MerylB2/Boite_stork_3D/3mf_bambu_tricolore/loquets_x14.3mf

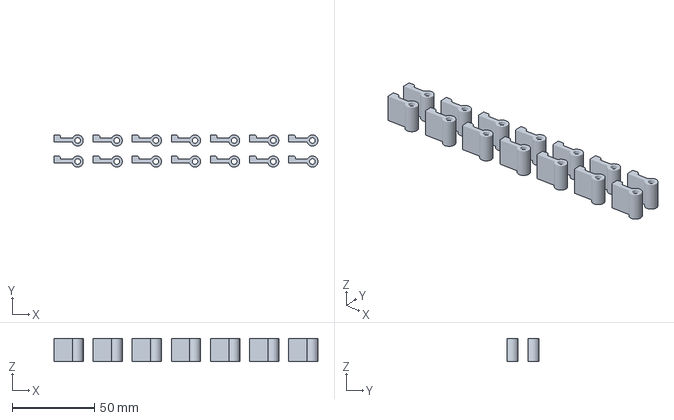
[picture p4: CAD file, 2026-10-30]
3mf_bambu_tricolore/loquets_x14.3mf
160.6 x 19.6 x 14.0 mm
