MerylB2/Boite_stork_3D/stl/7_kit_base_lwpla_couvercle.stl

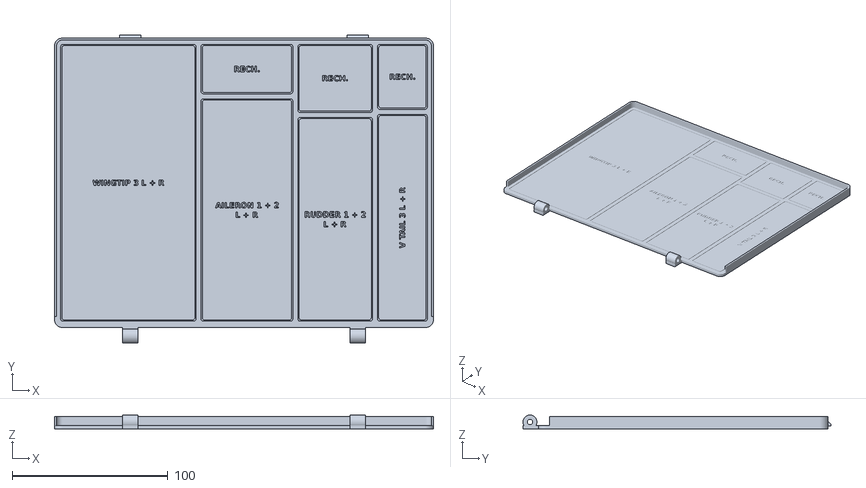
[picture p5: CAD file, 2026-10-30]
stl/7_kit_base_lwpla_couvercle.stl
243.6 x 198.0 x 9.00
