MerylB2/Boite_stork_3D/3mf_bambu_tricolore/7_kit_base_lwpla_boite.3mf

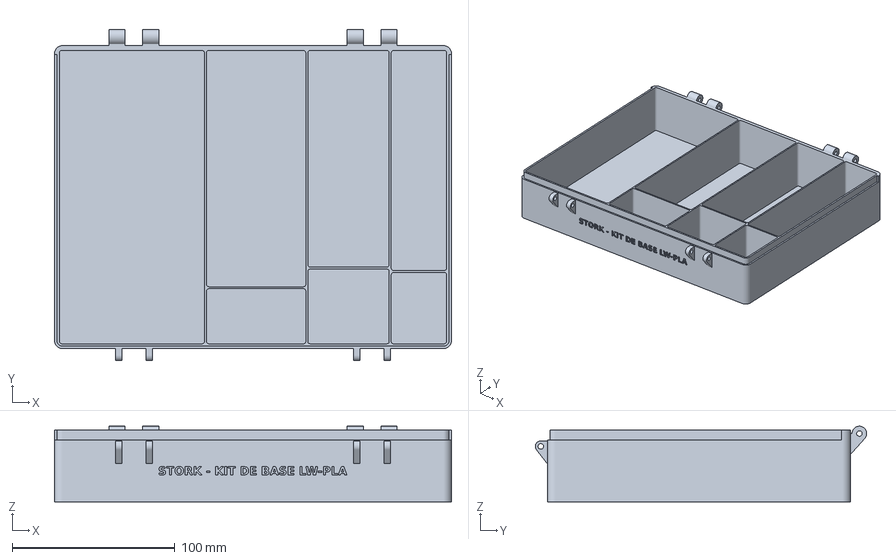
[picture p6: CAD file, 2026-10-30]
3mf_bambu_tricolore/7_kit_base_lwpla_boite.3mf
243.6 x 203.4 x 46.4 mm
