MerylB2/Boite_stork_3D/stl/2_moteurs_servos_couvercle.stl

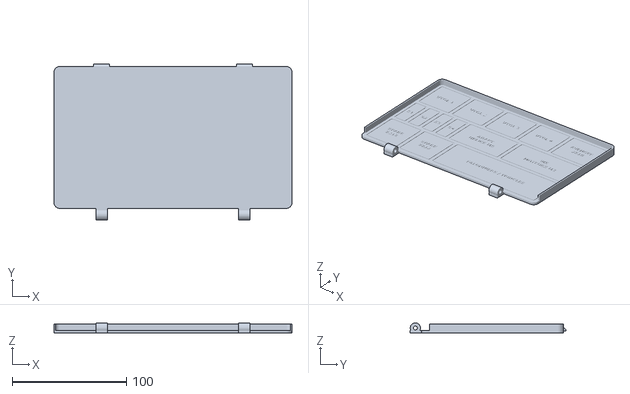
[picture p7: CAD file, 2026-10-30]
stl/2_moteurs_servos_couvercle.stl
208.0 x 136.0 x 9.00
