MerylB2/Boite_stork_3D/3mf_bambu_tricolore/2_moteurs_servos_boite.3mf

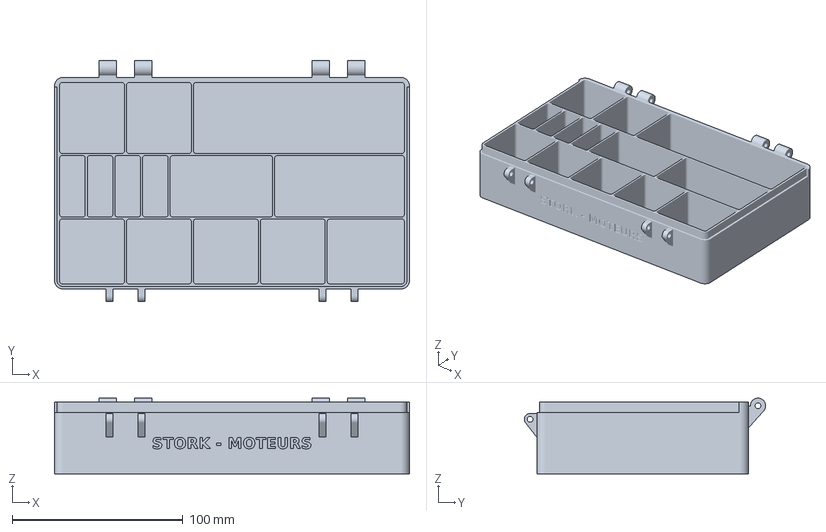
[picture p8: CAD file, 2026-10-30]
3mf_bambu_tricolore/2_moteurs_servos_boite.3mf
208.0 x 141.4 x 44.4 mm
