MerylB2/Boite_stork_3D/stl/4_quincaillerie_couvercle.stl

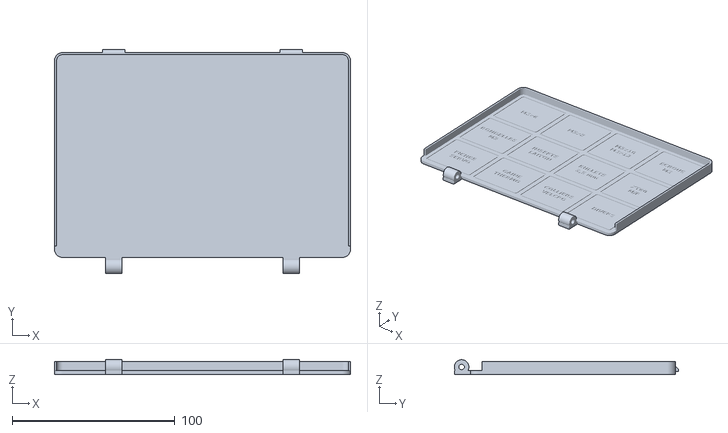
[picture p9: CAD file, 2026-10-30]
stl/4_quincaillerie_couvercle.stl
182.0 x 138.0 x 9.00
