MerylB2/Boite_stork_3D/3mf_bambu_tricolore/5_helices_boite.3mf

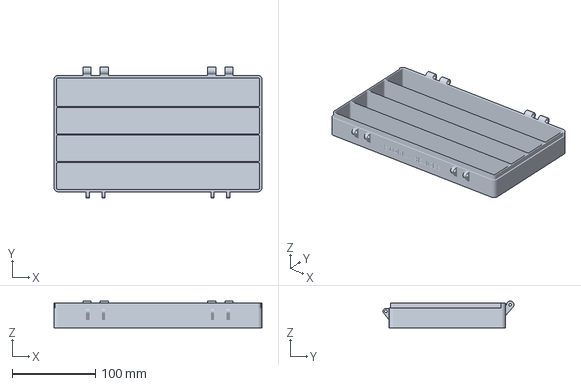
[picture p10: CAD file, 2026-10-30]
3mf_bambu_tricolore/5_helices_boite.3mf
250.0 x 157.4 x 32.4 mm
