MerylB2/Boite_stork_3D/stl/6_kit_base_petg_couvercle.stl

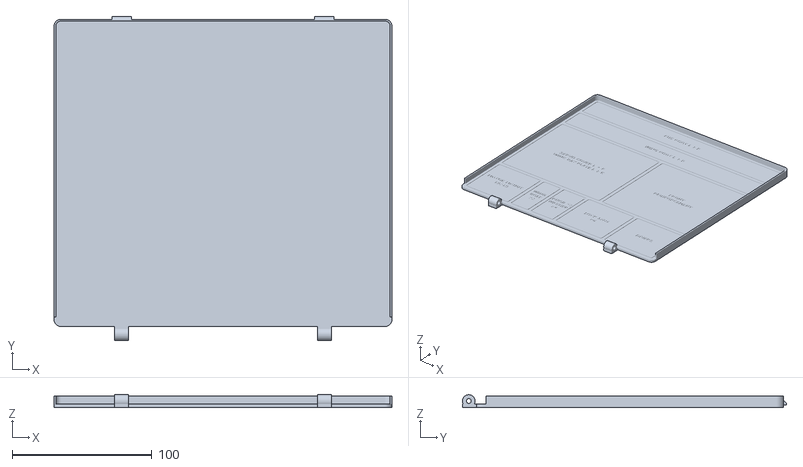
[picture p11: CAD file, 2026-10-30]
stl/6_kit_base_petg_couvercle.stl
242.0 x 232.0 x 9.00
