MerylB2/Boite_stork_3D/3mf_bambu_tricolore/2_moteurs_servos_couvercle.3mf

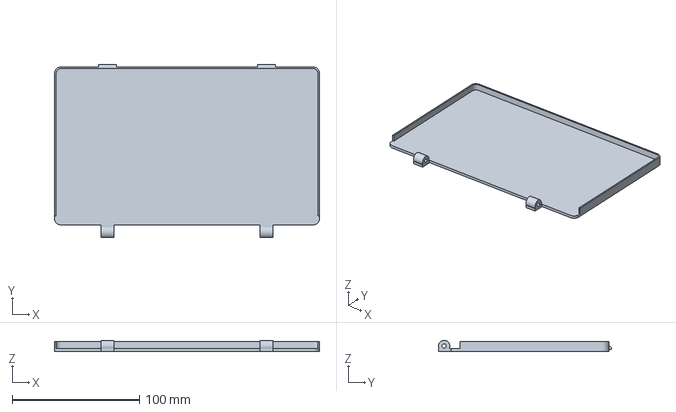
[picture p12: CAD file, 2026-10-30]
3mf_bambu_tricolore/2_moteurs_servos_couvercle.3mf
208.0 x 136.0 x 9.00 mm
