MerylB2/Boite_stork_3D/3mf_bambu_tricolore/6_kit_base_petg_boite.3mf

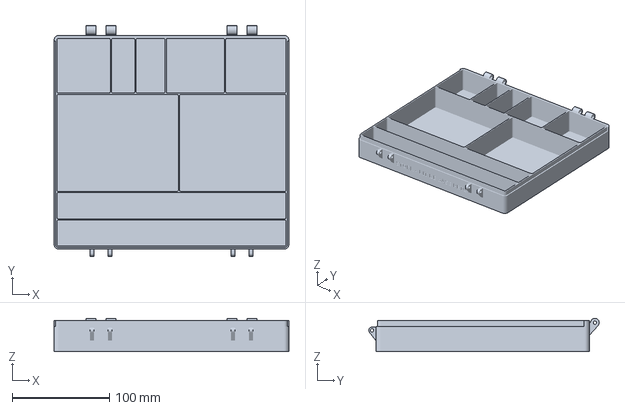
[picture p13: CAD file, 2026-10-30]
3mf_bambu_tricolore/6_kit_base_petg_boite.3mf
242.0 x 237.4 x 34.4 mm
