MerylB2/Boite_stork_3D/3mf_bambu_tricolore/4_quincaillerie_boite.3mf

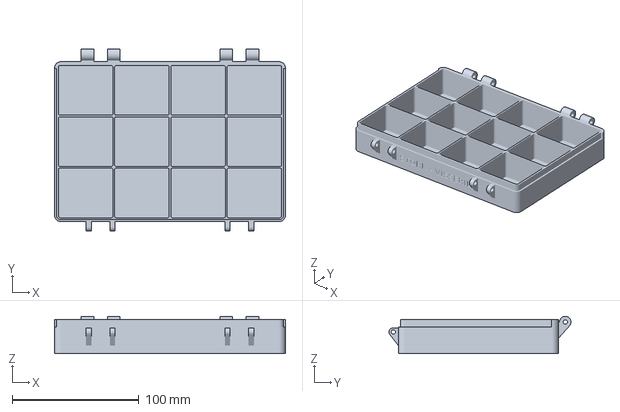
[picture p14: CAD file, 2026-10-30]
3mf_bambu_tricolore/4_quincaillerie_boite.3mf
182.0 x 143.4 x 29.4 mm
