MerylB2/Boite_stork_3D/stl/loquets_x2.stl

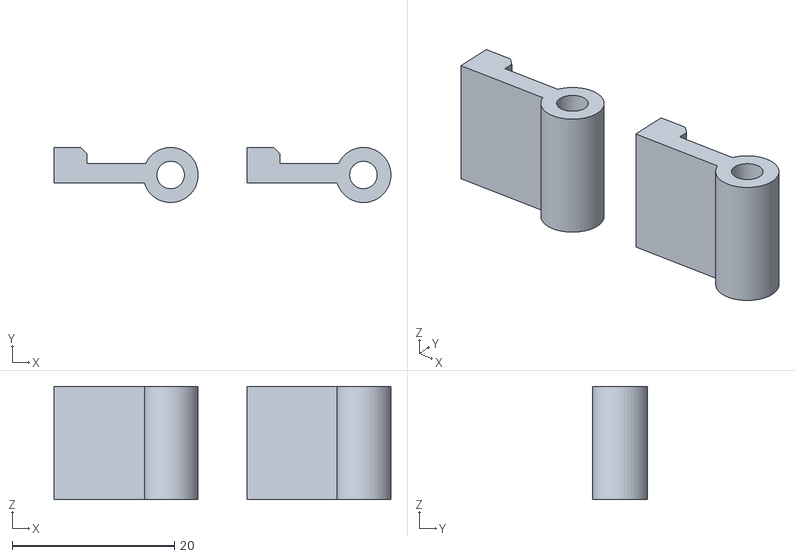
[picture p15: CAD file, 2026-10-30]
stl/loquets_x2.stl
41.6 x 6.80 x 14.0
