MerylB2/Boite_stork_3D/3mf_bambu_tricolore/3_pack_vtol_petg_couvercle.3mf

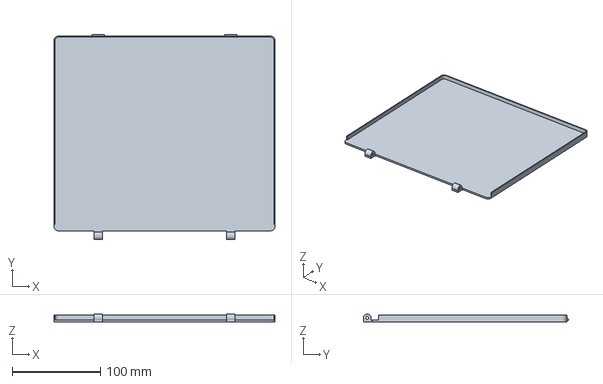
[picture p16: CAD file, 2026-10-30]
3mf_bambu_tricolore/3_pack_vtol_petg_couvercle.3mf
250.0 x 232.4 x 9.00 mm
