MerylB2/Boite_stork_3D/3mf_bambu_tricolore/5_helices_couvercle.3mf

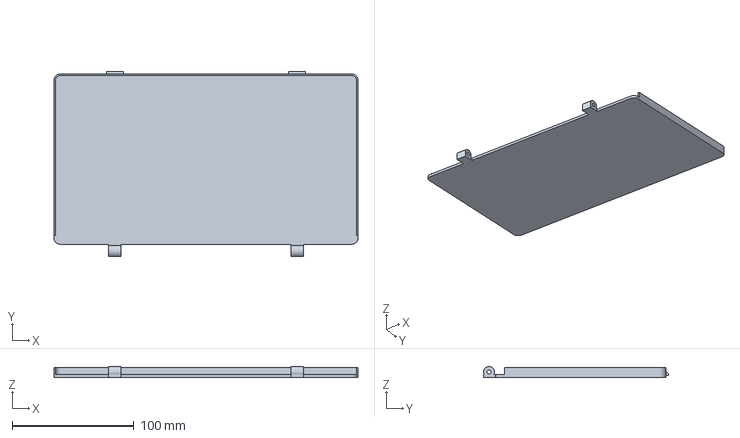
[picture p17: CAD file, 2026-10-30]
3mf_bambu_tricolore/5_helices_couvercle.3mf
250.0 x 152.0 x 9.00 mm
