MerylB2/Boite_stork_3D/stl/5_helices_couvercle.stl

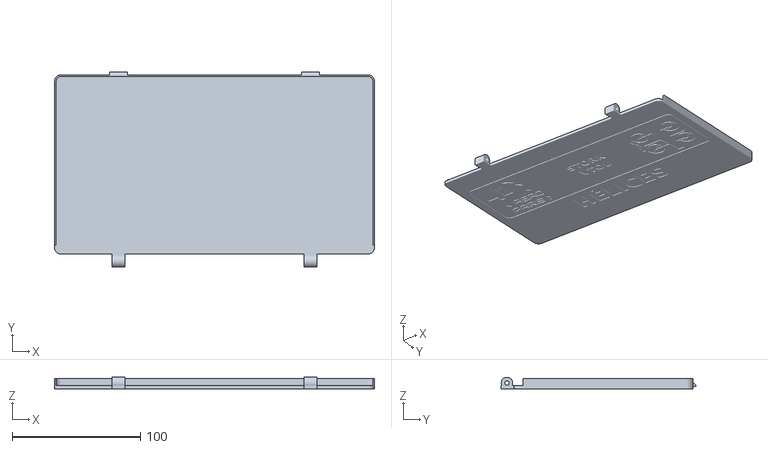
[picture p18: CAD file, 2026-10-30]
stl/5_helices_couvercle.stl
250.0 x 152.0 x 9.00
