MerylB2/Boite_stork_3D/3mf_bambu_tricolore/6_kit_base_petg_couvercle.3mf

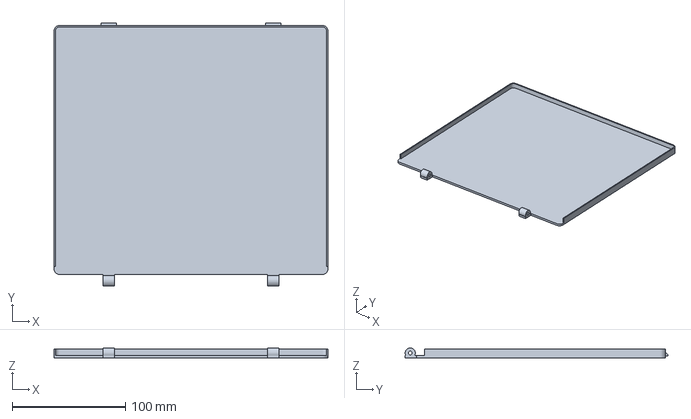
[picture p19: CAD file, 2026-10-30]
3mf_bambu_tricolore/6_kit_base_petg_couvercle.3mf
242.0 x 232.0 x 9.00 mm
