MerylB2/Boite_stork_3D/stl/3_pack_vtol_petg_boite.stl

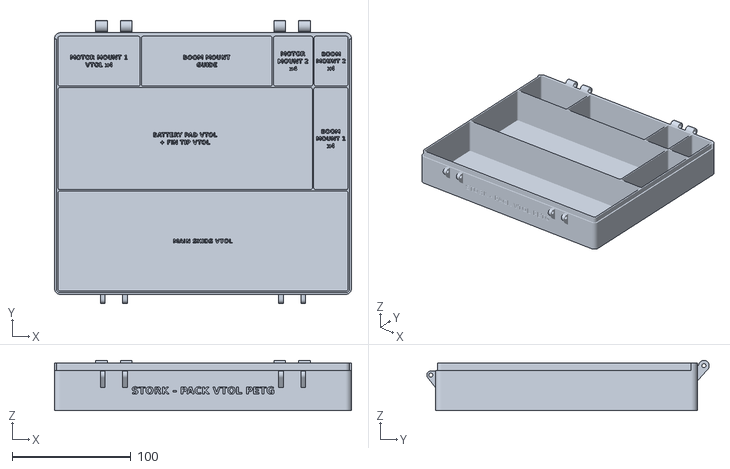
[picture p20: CAD file, 2026-10-30]
stl/3_pack_vtol_petg_boite.stl
250.0 x 237.8 x 42.4
