MerylB2/Boite_stork_3D/3mf_bambu_tricolore/1_electronique_couvercle.3mf

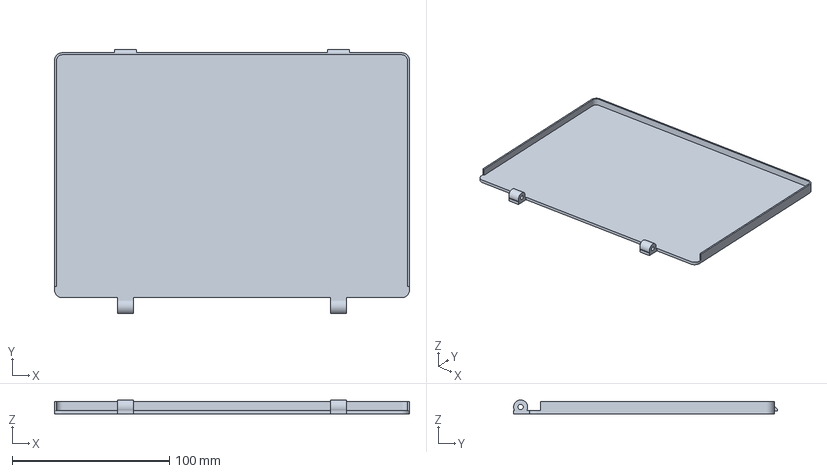
[picture p21: CAD file, 2026-10-30]
3mf_bambu_tricolore/1_electronique_couvercle.3mf
226.0 x 168.0 x 9.00 mm
