MerylB2/Boite_stork_3D/3mf_bambu_tricolore/7_kit_base_lwpla_couvercle.3mf

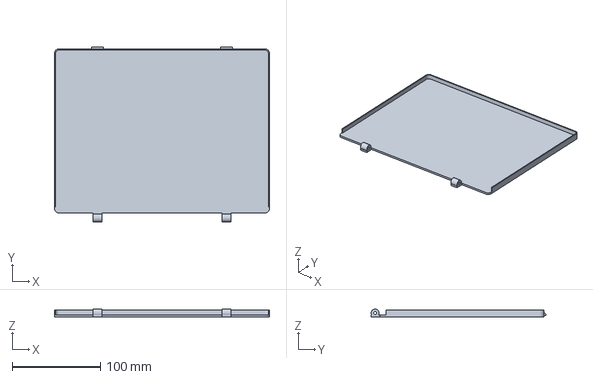
[picture p22: CAD file, 2026-10-30]
3mf_bambu_tricolore/7_kit_base_lwpla_couvercle.3mf
243.6 x 198.0 x 9.00 mm
