MerylB2/Boite_stork_3D/stl/1_electronique_boite.stl

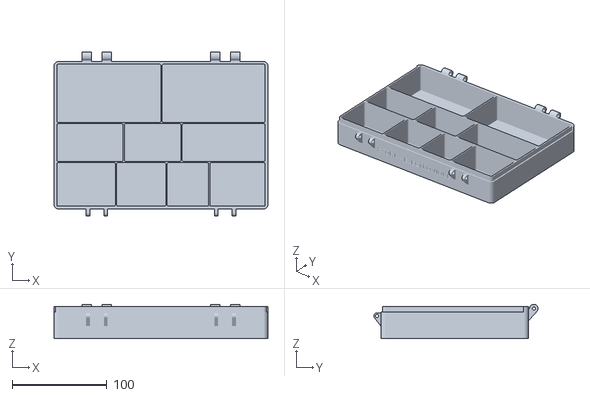
[picture p23: CAD file, 2026-10-30]
stl/1_electronique_boite.stl
226.0 x 173.4 x 36.4
