MerylB2/Boite_stork_3D/3mf_bambu_tricolore/4_quincaillerie_couvercle.3mf

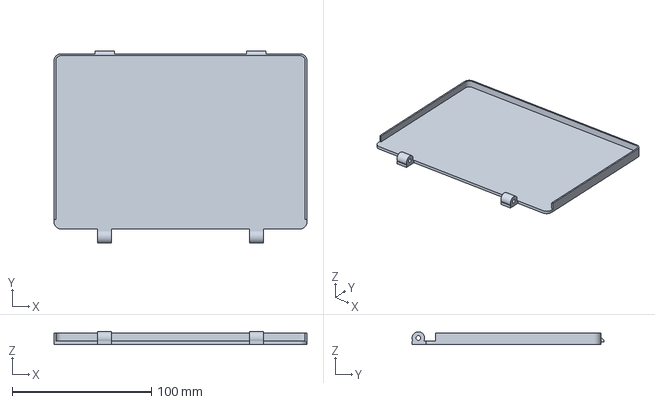
[picture p24: CAD file, 2026-10-30]
3mf_bambu_tricolore/4_quincaillerie_couvercle.3mf
182.0 x 138.0 x 9.00 mm
