MerylB2/Boite_stork_3D/stl/1_electronique_couvercle.stl

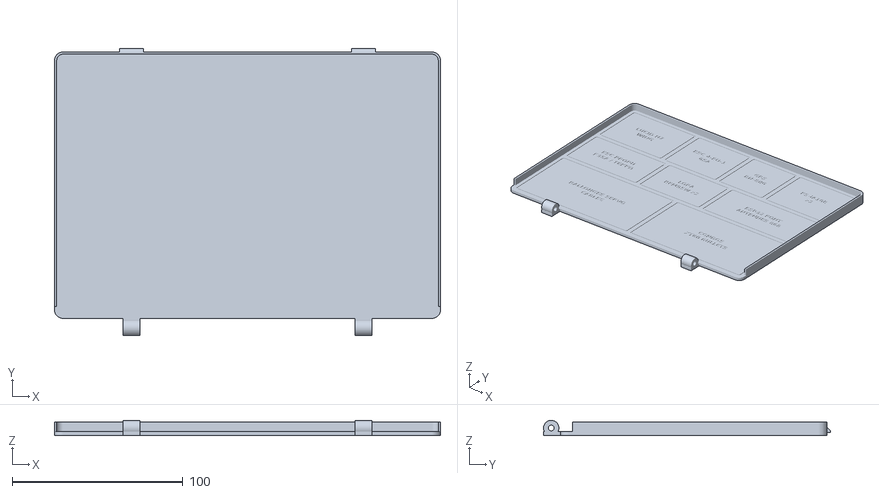
[picture p25: CAD file, 2026-10-30]
stl/1_electronique_couvercle.stl
226.0 x 168.0 x 9.00
