MerylB2/Boite_stork_3D/stl/3_pack_vtol_petg_couvercle.stl

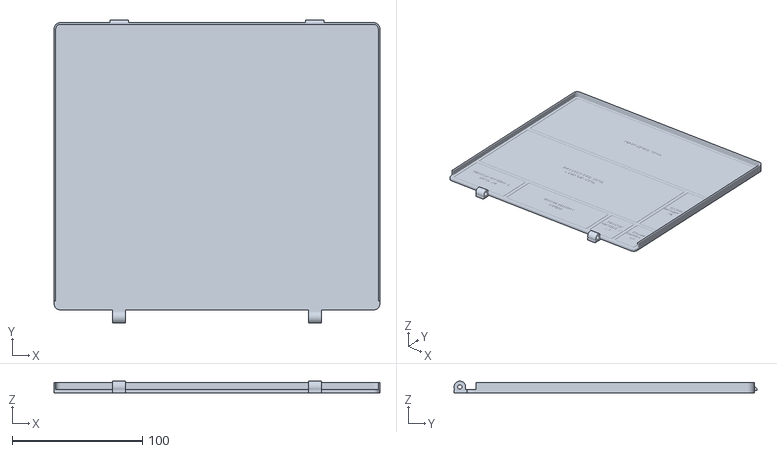
[picture p26: CAD file, 2026-10-30]
stl/3_pack_vtol_petg_couvercle.stl
250.0 x 232.4 x 9.00
