MerylB2/Boite_stork_3D/stl/4_quincaillerie_boite.stl

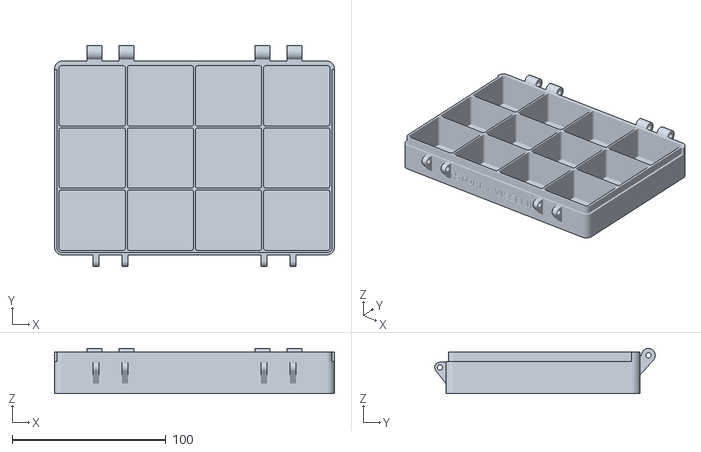
[picture p27: CAD file, 2026-10-30]
stl/4_quincaillerie_boite.stl
182.0 x 143.4 x 29.4
