MerylB2/Boite_stork_3D/(list of files, cad)

Other CAD files:
stl/7_kit_base_lwpla_boite.stl
stl/loquets_x14.stl
stl/6_kit_base_petg_boite.stl
stl/2_moteurs_servos_boite.stl
3mf_bambu_tricolore/loquets_x2.3mf
stl/5_helices_boite.stl
3mf_bambu_tricolore/1_electronique_boite.3mf
3mf_bambu_tricolore/3_pack_vtol_petg_boite.3mf
