MerylB2/Boite_stork_3D/(commit log)

2026-10-30 Charnière et loquets de fermeture
2026-10-30 Décor des couvercles (badge, logo, quadplane)
2026-10-30 Script de génération des boîtes compartimentées
2026-10-30 STL monochromes des 7 boîtes, couvercles et loquets
    [1_electronique_boite.stl, 1_electronique_couvercle.stl, 2_moteurs_servos_boite.stl, 2_moteurs_servos_couvercle.stl, 3_pack_vtol_petg_boite.stl, 3_pack_vtol_petg_couvercle.stl, 4_quincaillerie_boite.stl, 4_quincaillerie_couvercle.stl]
2026-10-30 3MF tricolores pour Bambu X1C (AMS)
    [1_electronique_boite.3mf, 1_electronique_couvercle.3mf, 2_moteurs_servos_boite.3mf, 2_moteurs_servos_couvercle.3mf, 3_pack_vtol_petg_boite.3mf, 3_pack_vtol_petg_couvercle.3mf, 4_quincaillerie_boite.3mf, 4_quincaillerie_couvercle.3mf]
2026-10-30 Images d'aperçu des boîtes, du décor et de la fermeture
2026-10-30 Fiche README des boîtes de rangement
